yaswanthsk04/BinAlert/Presentations/SGC_Business_1st_ver_MB.pptx

Embedded Systems Entrepreneurship

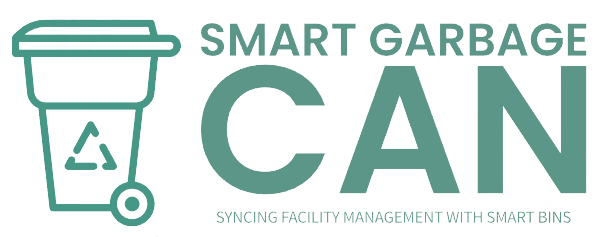
[picture p13: figure]

Busniess Pitch Deck

## Problem Statement

Facility managers grapple with supervising waste disposal for multiple buildings due to unpredictable garbage collection schedules. The prolonged exposure of waste not only impacts operational efficiencies but also ruins the aesthetics and cleanliness of the facilities.

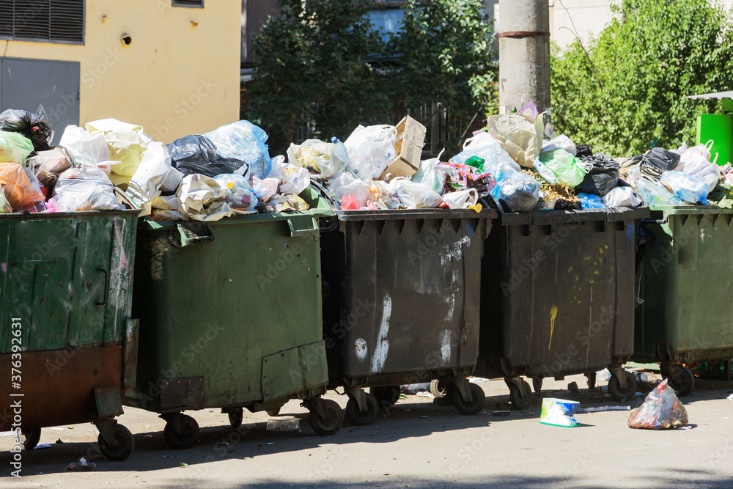
[picture p14: figure]
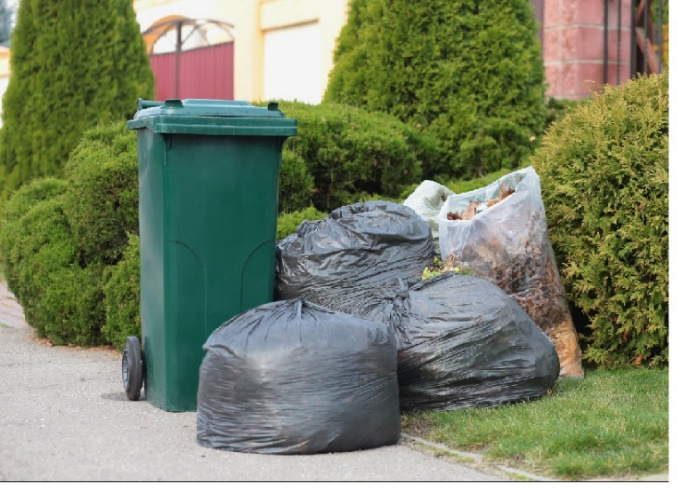
[picture p15: figure]
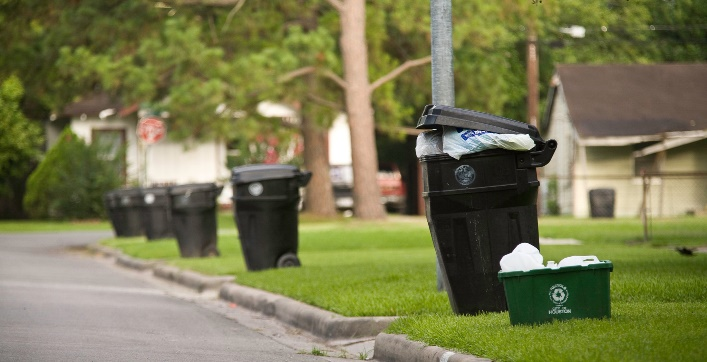
[picture p16: figure]

## Driven Innovation

- Addressing a critical real-world problem faced by facility managers.
- Utilizing innovative sensor technology and machine learning for efficient waste management.
- Creating a positive social and environmental impact by promoting sustainability.
- Exploring potential business opportunities in the growing smart waste management market.

## Existing Solution

May be a bit few words about this slide

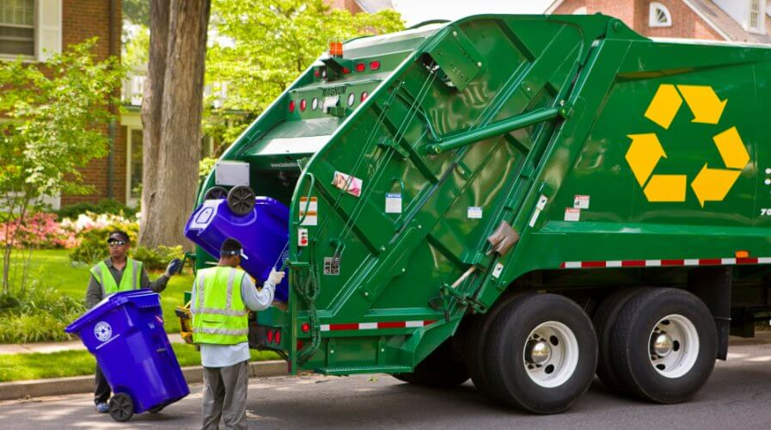
[picture p17: figure]

## Our Solution

- Leverages sensor technology and machine learning.
- MPU6050 Sensor monitors garbage bin acceleration data.
- Machine learning model detects emptied bins accurately.
- Real-time notifications to facility managers.

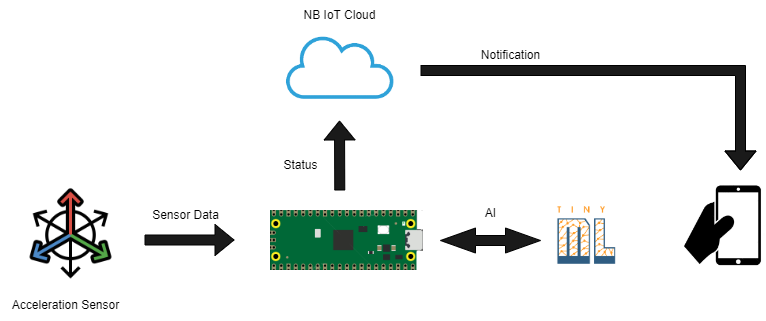
[picture p18: figure]

## Empowering Solutions!

- Cleaner sustainable environment
- Automated bin notifications
- Automated Route Planning

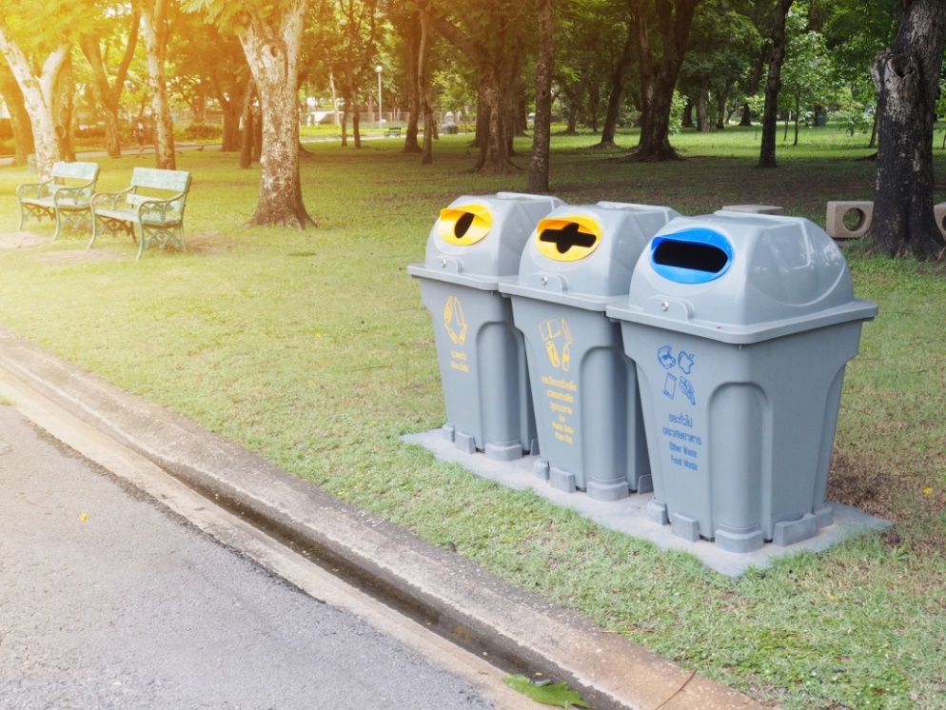
[picture p19: figure]

## Slide 7

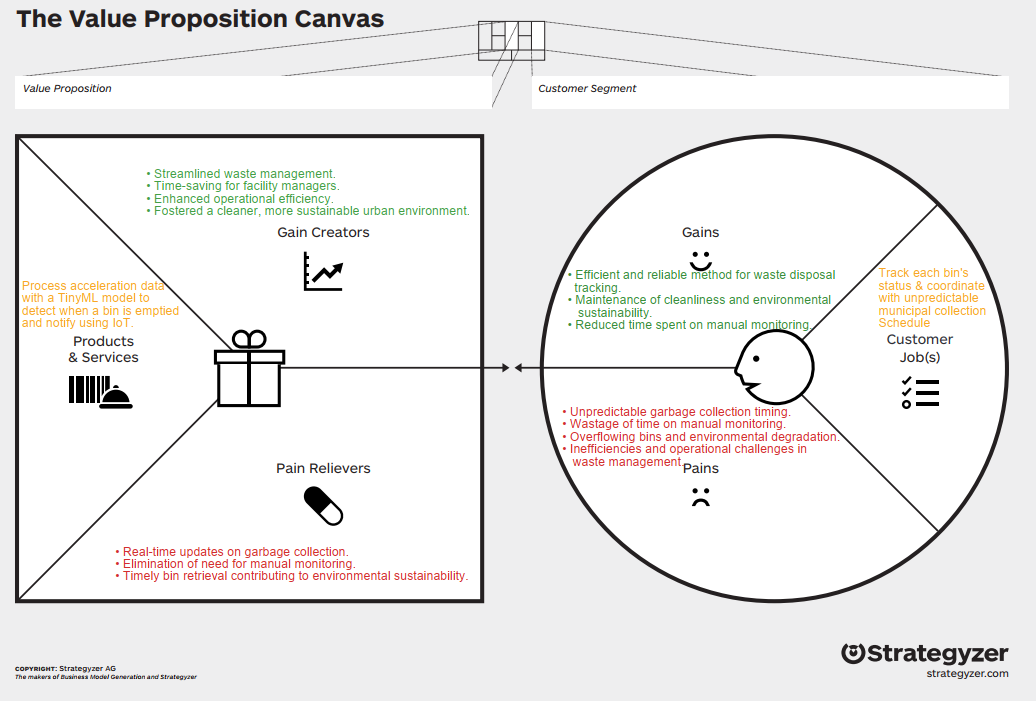
[picture p20: figure]

Source: Strategyzer (https://www.strategyzer.com/canvas/value-proposition-canvas)

## Slide 8

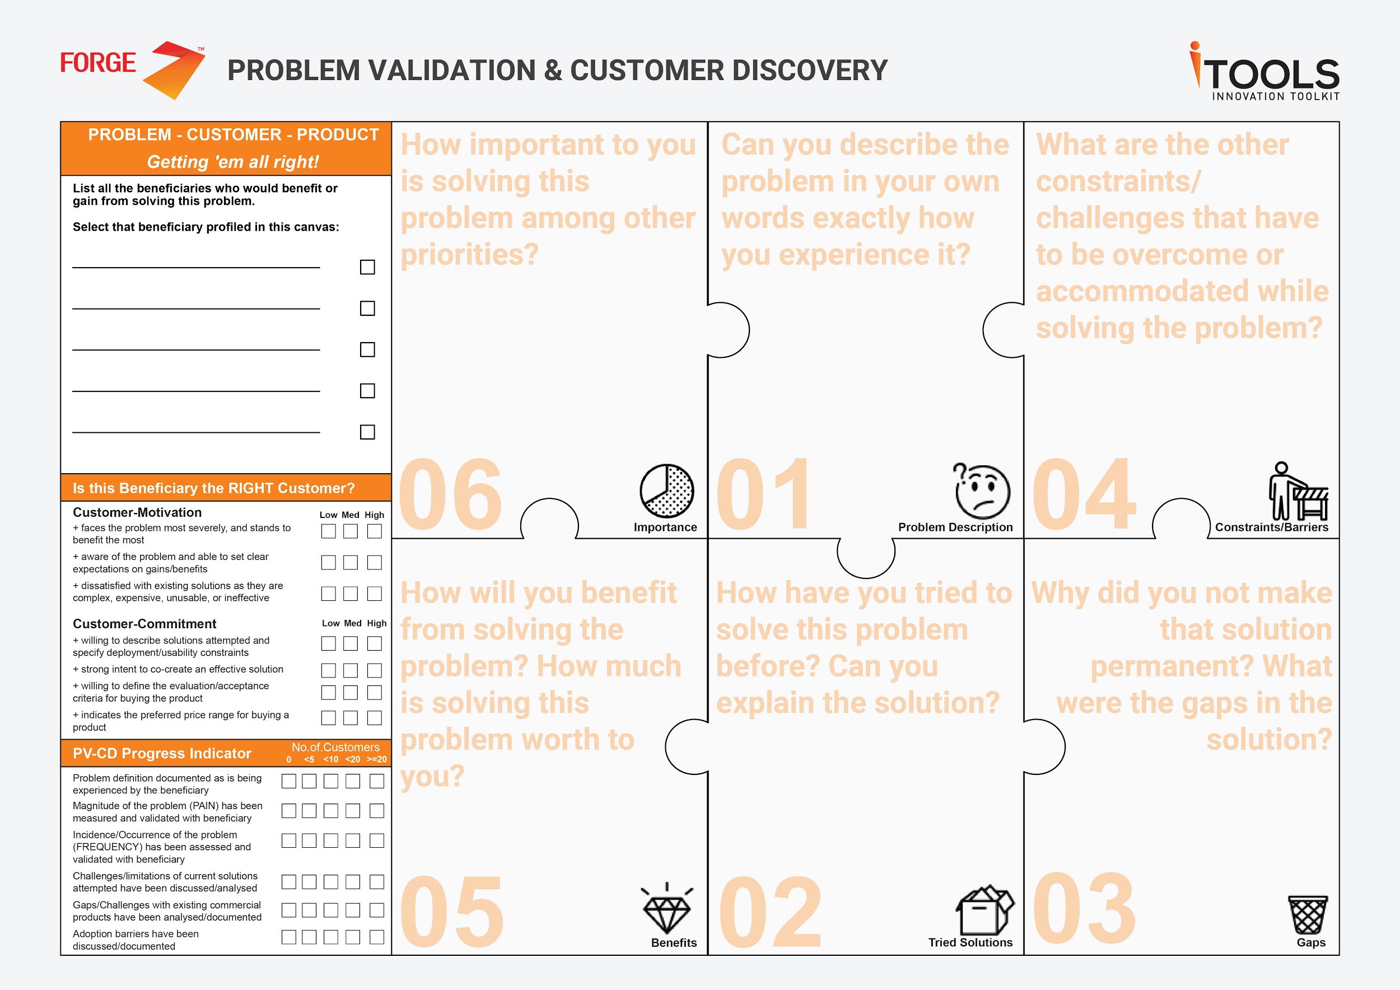
[picture p21: figure]

Facility Managers

- Unpredictable schedules and waste exposure create inefficiencies.
- Reduce labour cost

Supervising waste disposal for multiple buildings

Budget constraints
Scalability

This slide could be removed

- Manual Monitoring and Scheduling
- Fixed collection days

- Manual labour intensive
- Inconsistent schedules
- Environmental impact

- Operational efficiency
- Cost savings
- Enhanced reputation

Source: Forge Accelerator (https://www.forgeforward.in/)

## Market Size

- Europe holds the third largest share of the global facility management market & is projected to grow from $290.4 billion in 2022 to $426.6 billion by 2030.
- The Germany Facility Management Market is expected to register a CAGR above 3.58% from 2022 to 2027.
- Smart Garbage Can system is applicable across diverse sectors.

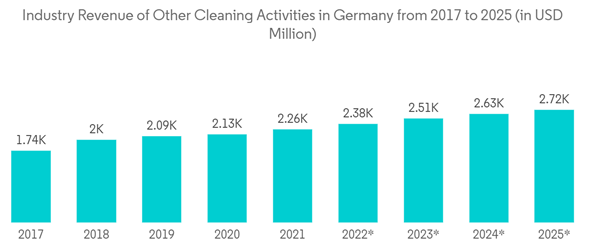
[picture p22: figure]

Source: Research & Markets (https://www.researchandmarkets.com/reports/5601164/germany-facility-management-market-growth)

## Potential Customer Profiles from black forest

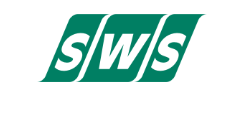
[picture p23: figure]

https://www.schwarzwaelder-service.de/

https://www.reppdienstleistungen.de/

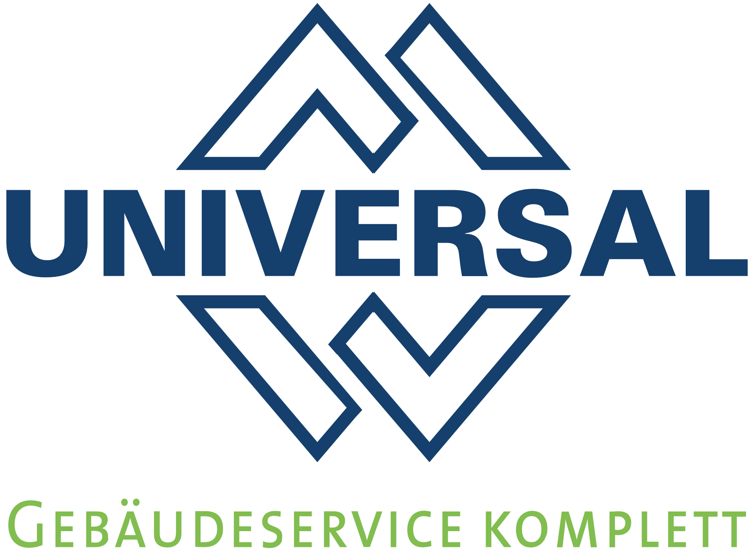
[picture p24: figure]

http://www.abr-gm.de/

https://www.universal-dienstleistungen.de/

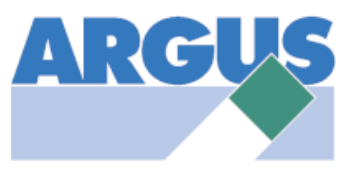
[picture p25: figure]
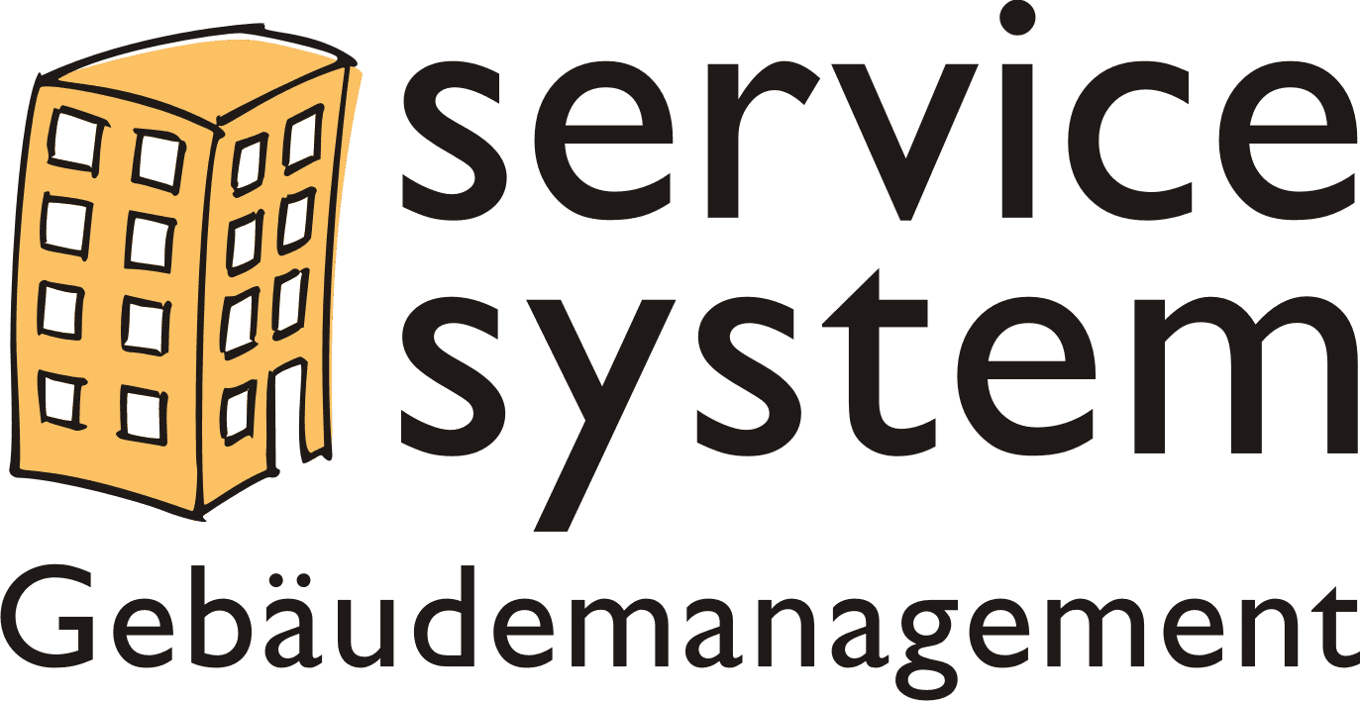
[picture p26: figure]

https://servicesystem.eu/

https://www.argus-dienstleistungen.de/

## Competitors

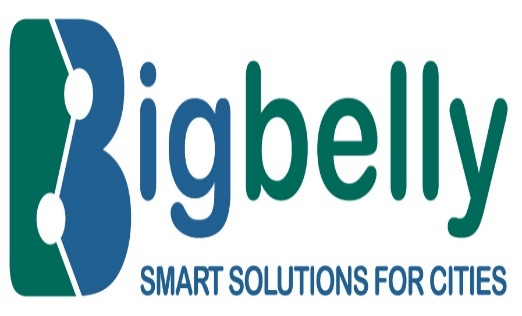
[picture p27: figure]
Bigbelly - The World Leader in Smart Waste & Recycling
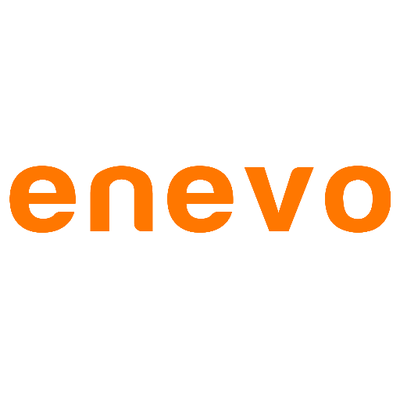
[picture p28: figure]
Enevo (@enevo) / Twitter
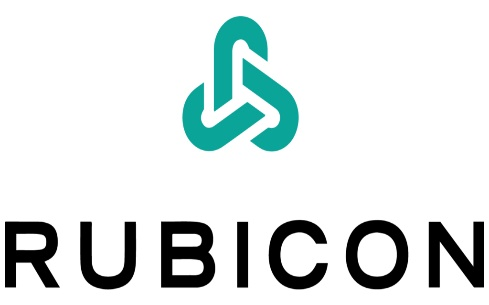
[picture p29: figure]
Rubicon Enters Multi-Year Channel Partnership with UK Municipal Innovation Leader, Bartec | Business Wire
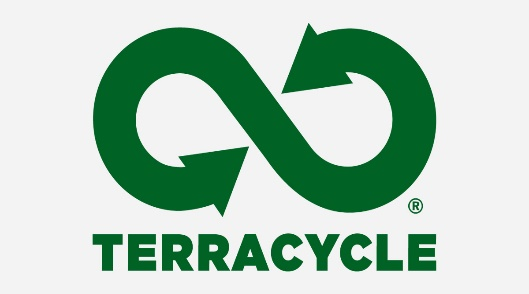
[picture p30: figure]
D.I.Y · TerraCycle
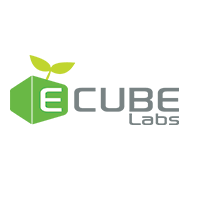
[picture p31: figure]
Ecube labs – wisebusiness.eu
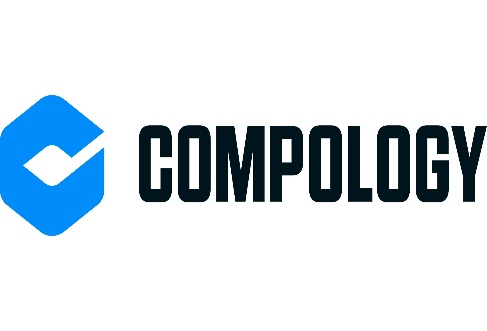
[picture p32: figure]
Compology Brings AI-powered Waste Metering™ to the Multifamily Housing Market with RealPage
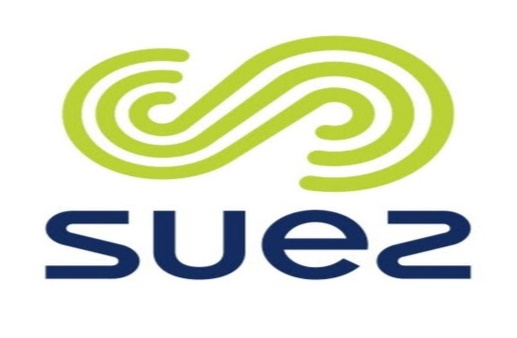
[picture p33: figure]
SUEZ group - YouTube
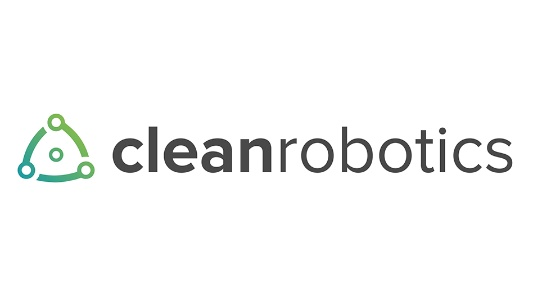
[picture p34: figure]
CleanRobotics announces new features for TrashBot autonomous scrap-sorting bin - Recycling Today

## Team:

Mohamed Bourouah

Hahn-Schickard

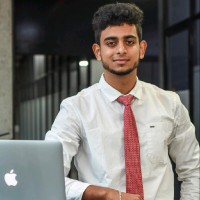
[picture p35: figure]
Ajeeth Venkat Prasat
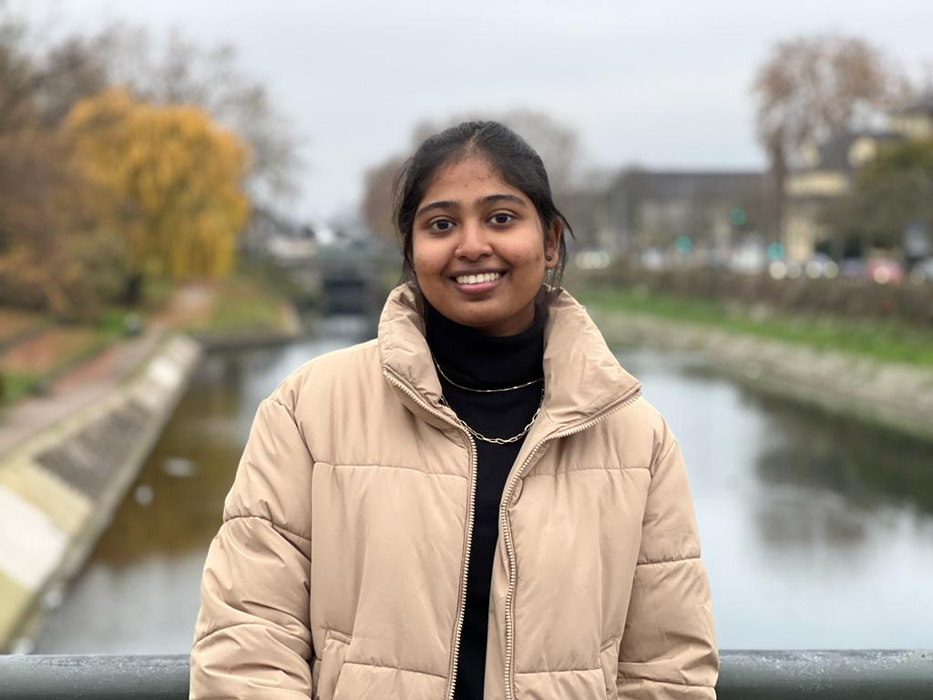
[picture p36: figure]
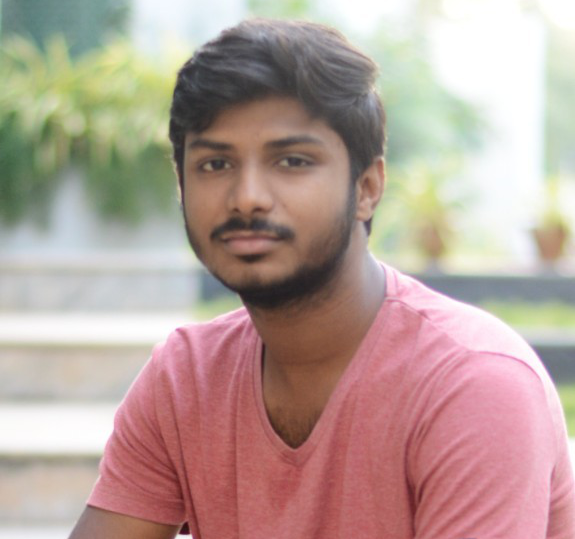
[picture p37: figure]
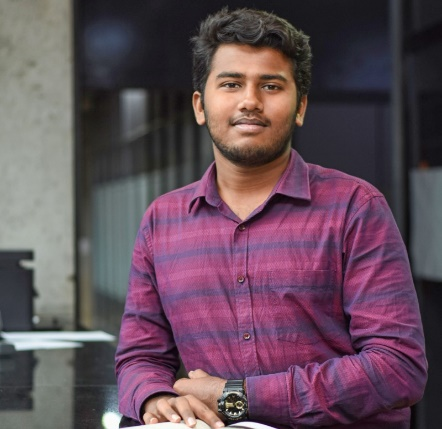
[picture p38: figure]
profile image

Ajeeth V

M.Sc. Embedded Systems, University of Freiburg

Keerthana M

M.Sc. Embedded Systems, University of Freiburg

Sheren

M.Sc. Embedded Systems, University of Freiburg

Yaswanthkumar S K

M.Sc. Embedded Systems, University of Freiburg

## Why US?

## SWOT Analysis of our Team

Strengths Diverse skill set Strong ML and IoT knowledge Task distribution | Weakness Limited members on hardware: Potential for unbalanced workload:
Opportunities Cross-domain learning Innovating in IoT and ML | Threats Dependence on individual skills Fast-paced advancements in ML and IoT

## Any Questions?

- ~~Thank~~ ~~you~~~~!~~
